dewhisna/LCDInterface_FFCP/README.md

# LCDInterface_FFCP

This repository contains custom LCD/SDCard/Keypad Interface board designs for the FlashForge Creator Pro printer (primarily the 2016 model FFCP).
