dewhisna/LCDInterface_FFCP/LCDInterface_FFCP-V1/LCDInterface_FFCP.xls

Quantity | References | Source | Order Part | Value | Description | Notes
9 | C1,C2,C3,C5,C6,C7,C9,C10,C11 | DigiKey | 478-3618-1-ND | 0.1uF | 0.10µF ±10% 50V Ceramic Capacitor X8R 1206
2 | C4,C8 | DigiKey | 493-9444-1-ND | 47uF 10V | UUA1A470MCL1GS: 47uF 10V SMD 6.3mmX5.8mm, 105C, cap
2 | D1,D3 | DigiKey | 160-1404-1-ND | LTST-C150KGKT | Lite-On LTST-C150KGKT Green LED, 1206 SMT | Optional
1 | D2 | DigiKey | 160-1404-1-ND | LTST-C150KRKT | Lite-On LTST-C150KRKT Red LED, 1206 SMT | Optional
1 | J1 | Amazon | B00PZNZNCM or B00E1L9YD8 | #19608 | 4UCon #19608 SDCard Socket
1 | P1 | DigiKey | S9181-ND | SBH11-PBPC-D13-RA-BK | Sullins 26-pin Male Right-Angle through-hole 0.100" dual row header
1 | P2 | DigiKey | SAM1011-16-ND | BCS-116-L-S-TE | 16-pin Female straight through-hole 0.100" single row header
1 | P3 | DigiKey | SAM1011-12-ND | BCS-112-L-S-TE | 12-pin Female straight through-hole 0.100" single row header
1 | R3 | DigiKey | 311-22.0FRCT-ND | 22 Ohm | 22 Ohm ±1% 0.25W, 1/4W Chip Resistor 1206 Moisture Resistant Thick Film
1 | R6 | DigiKey | 311-220FRCT-ND | 220 Ohm | 220 Ohm ±1% 0.25W, 1/4W Chip Resistor 1206 Moisture Resistant Thick Film
1 | R19 | DigiKey | 311-330FRCT-ND | 330 Ohm | 330 Ohm ±1% 0.25W, 1/4W Chip Resistor 1206 Moisture Resistant Thick Film | Only Populate if installing D3
2 | R5,R7 | DigiKey | 311-560FRCT-ND | 560 Ohm | 560 Ohm ±1% 0.25W, 1/4W Chip Resistor 1206 Moisture Resistant Thick Film | Only Populate if installing corresponding D1 and/or D2
5 | R14,R15,R16,R17,R18 | DigiKey | 311-1.00KFRCT-ND | 1K Ohm | 1K Ohm ±1% 0.25W, 1/4W Chip Resistor 1206 Moisture Resistant Thick Film
1 | R8 | DigiKey | 311-2.20KFRCT-ND | 2.2K Ohm | 2.2K Ohm ±1% 0.25W, 1/4W Chip Resistor 1206 Moisture Resistant Thick Film | Only Populate if not installing RV1
8 | R1,R2,R4,R9,R10,R11,R12,R13 | DigiKey | 311-10.0KFRCT-ND | 10K Ohm | 10K Ohm ±1% 0.25W, 1/4W Chip Resistor 1206 Moisture Resistant Thick Film | Only Populate R4 if not installing RV1
1 | RV1 | DigiKey | TC33X-103ECT-ND | 10K Ohm Trimmer | 10k Ohm 0.1W, 1/10W J Lead SMT Trimmer Potentiometer Cermet 1 Turn Top Adj. | Only Populate if not installing R4 and R8
3 | TV1,TV2,TV3 | DigiKey | 497-3711-1-ND | ESDA6V1U1RL | TVS Diode Array, 8-SOIC
4 | U1,U2,U3,U4 | DigiKey | 568-5461-1-ND | 74LVC1T45GW,125 | Voltage Level Translator Bidirectional 1 Circuit 1 Channel 420Mbps 6-TSSOP
1 | U5 | DigiKey | 568-2257-1-ND | HEF4094BT,653 | 8-stage shift-register, 16-SOIC
1 | U6 | DigiKey | LM1117MP-3.3/NOPBCT-ND | LM1117MP-3.3 | Linear Voltage Regulator IC Positive Fixed 1 Output 3.3V 800mA SOT-223
2 | N/A | DigiKey | 240-2103-ND | Ferrite Core | Clip-Together Ferrite Core 250 Ohm @ 100MHz
