dewhisna/LCDInterface_FFCP/LCDInterface_FFCP-V1/LCDInterface_FFCP.pdf

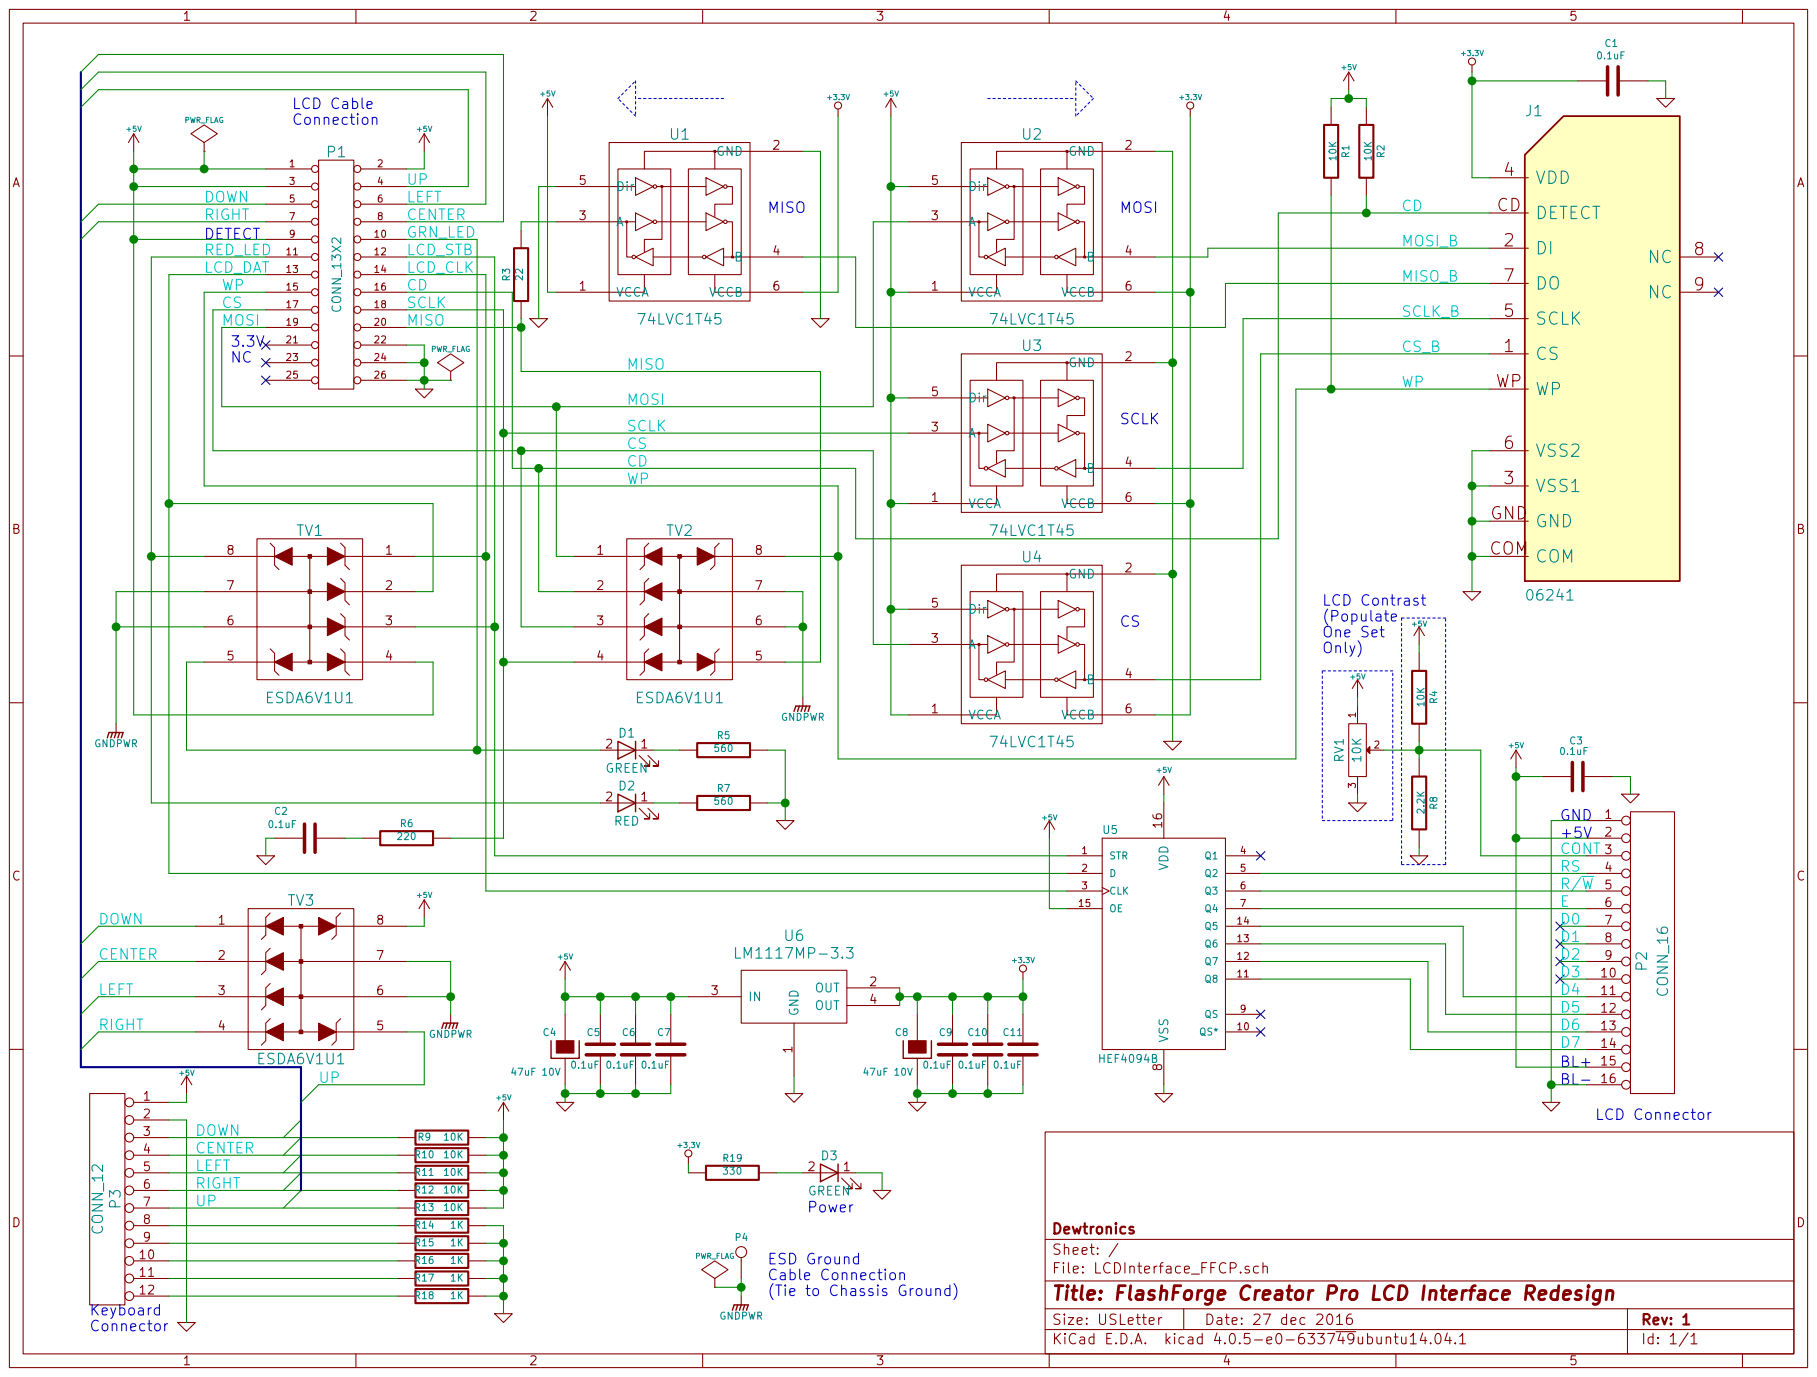
[picture p1: page 1]

DOWN 5 | | 6
RIGHT | | 7 | | 8
DETECT | | 9 | | 10

11 | | 12 | LCD_STB

LCD_DAT | 13 | | 14 | LCD_CLK

15 | | 16
17 | | SCLK 18

MOSI | | | 20

VCCB | 4 Dir 5 6 U3

SCLK
CS
CD

8 QS 9 QS* 10 Q8 11 Q7 12 Q6 13 Q5 14 OE 15 VDD 16 U5 HEF4094B

R/W 5
E 6

File: LCDInterface_FFCP.sch Sheet: / Dewtronics

Cable Connection
(Tie to Chassis Ground)

Id: 1/1 Title: FlashForge Creator Pro LCD Interface Redesign
