dewhisna/LCDInterface_FFCP/LCDInterface_FFCP-V1/LCDInterface_FFCP.kicad_pcb

## KiCad design LCDInterface_FFCP-V1/LCDInterface_FFCP.kicad_pcb (2019-07-04)

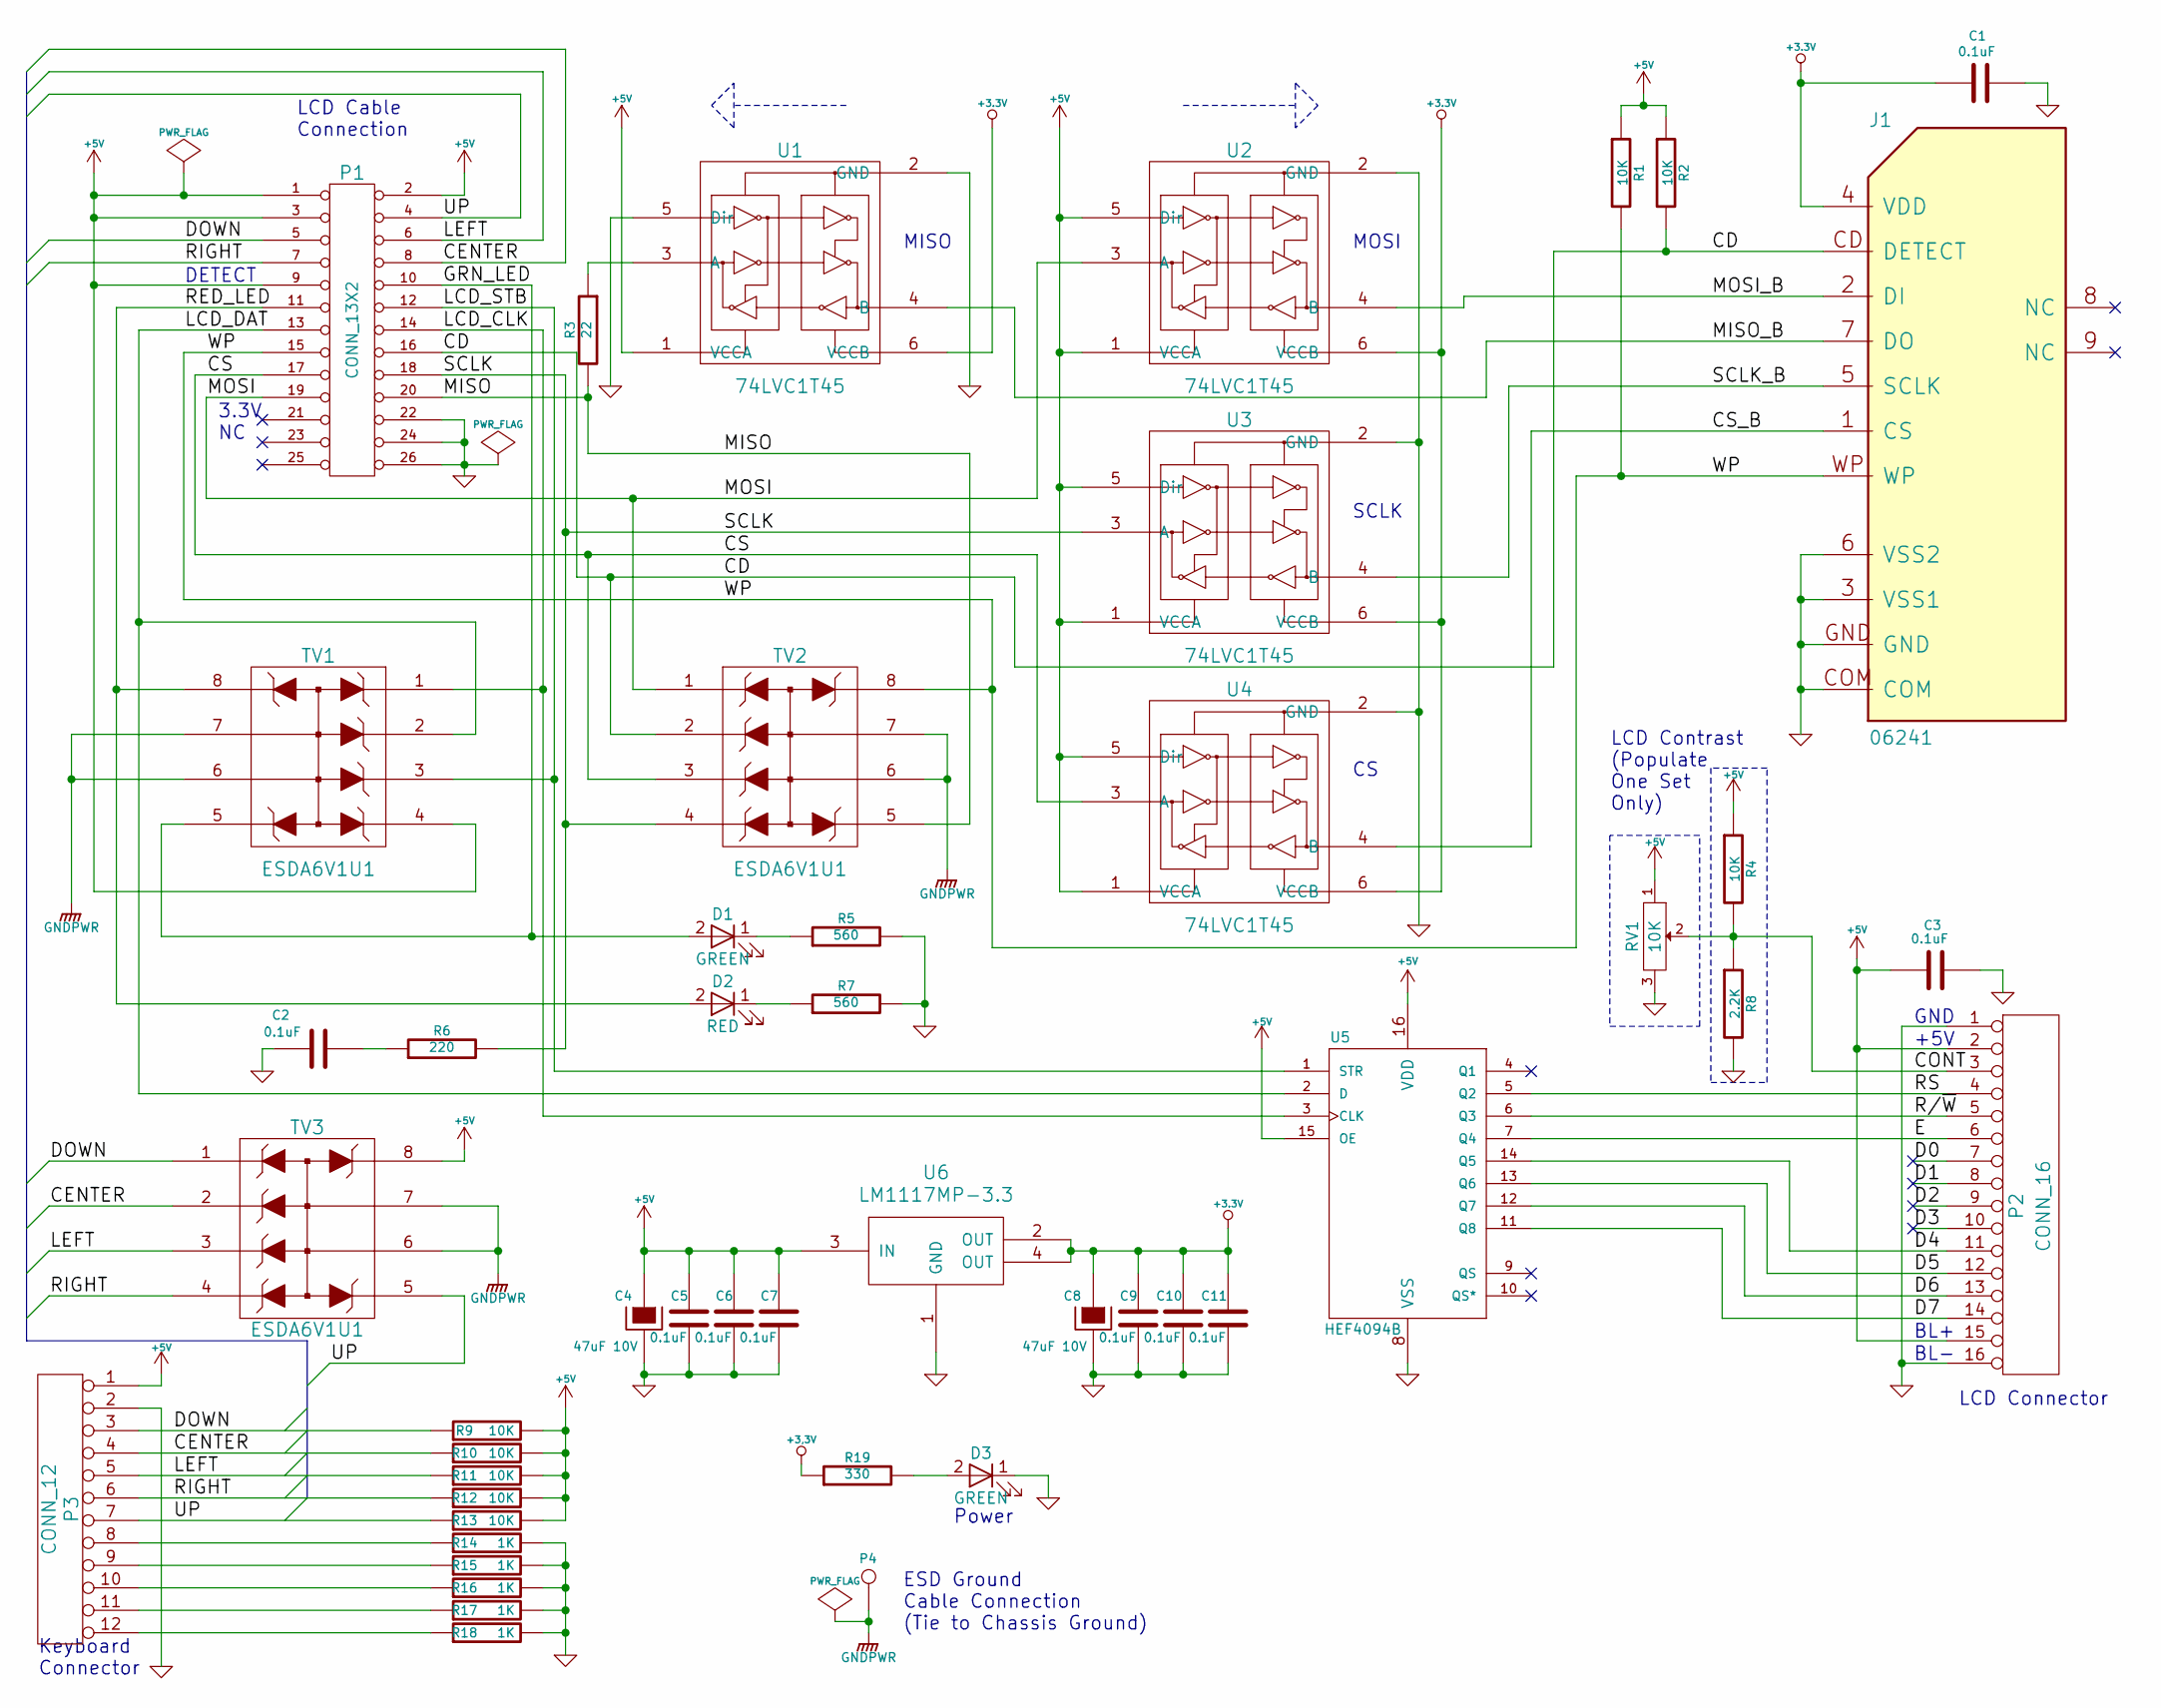
[picture p2: schematic LCDInterface_FFCP.sch, FlashForge Creator Pro LCD Interface Redesign]

Parts:
C1, C2, C3, C5, C6, C7, C9, C10, C11: 0.1uF; C_1206_HandSoldering
C4, C8: 47uF 10V; c_elec_6.3x5.8
D1, D3: GREEN; LED_1206
D2: RED; LED_1206
J1: 06241; SDCARD-SOCKET
P1: CONN_13X2; PAK100_2500-5-26
P2: CONN_16; con-molex-70543-16
P3: CONN_12; con-molex-70543-12
P4: CONN_1; 1pin
R1, R2, R4, R9, R10, R11, R12, R13: 10K; R_1206_HandSoldering
R3: 22; R_1206_HandSoldering
R5, R7: 560; R_1206_HandSoldering
R6: 220; R_1206_HandSoldering
R8: 2.2K; R_1206_HandSoldering
R14, R15, R16, R17, R18: 1K; R_1206_HandSoldering
R19: 330; R_1206_HandSoldering
RV1: 10K; Potentiometer_Trimmer-EVM3E
TV1, TV2, TV3: ESDA6V1U1; 74xx-us-SO08
U1, U2, U3, U4: 74LVC1T45; SC-70-6_Handsoldering
U5: HEF4094B; 74xx-us-SO16
U6: LM1117MP-3.3; SOT-223

Connections:
+5V: C3.1, C4.1, C5.1, C6.1, C7.1, P1.1, P1.2, P1.3, P1.9, P2.2, P2.15, P3.1, R1.1, R2.1, R4.1, R9.2, R10.2, R11.2, R12.2, R13.2, RV1.1, TV1.4 (I/O_4), TV3.8 (I/O_6), U1.1 (VCCA), U2.1 (VCCA), U2.5 (Dir), U3.1 (VCCA), U3.5 (Dir), U4.1 (VCCA), U4.5 (Dir), U5.15 (OE), U5.16 (VDD), U6.3 (IN)
/CD: J1.CD (DETECT), P1.16, R2.2, TV2.2 (I/O_2)
/CENTER: P1.8, P3.4, R10.1, TV3.2 (I/O_2)
/CONT: P2.3, R4.2, R8.1, RV1.2
/CS: P1.17, TV2.3 (I/O_3), U4.3 (A)
/CS_B: J1.1 (CS), U4.4 (B)
/D0: P2.7
/D1: P2.8
/D2: P2.9
/D3: P2.10
/D4: P2.11, U5.14 (Q5)
/D5: P2.12, U5.13 (Q6)
/D6: P2.13, U5.12 (Q7)
/D7: P2.14, U5.11 (Q8)
/DOWN: P1.5, P3.3, R9.1, TV3.1 (I/O_1)
/E: P2.6, U5.7 (Q4)
/GRN_LED: D1.2 (A), P1.10, TV1.5 (I/O_5)
/LCD_CLK: P1.14, TV1.1 (I/O_1), U5.3 (CLK)
/LCD_DAT: P1.13, TV1.2 (I/O_2), U5.2 (D)
/LCD_STB: P1.12, TV1.3 (I/O_3), U5.1 (STR)
/LEFT: P1.6, P3.5, R11.1, TV3.3 (I/O_3)
/MISO: P1.20, R3.2, TV2.5 (I/O_5)
/MISO_B: J1.7 (DO), U1.4 (B)
/MOSI: P1.19, TV2.1 (I/O_1), U2.3 (A)
/MOSI_B: J1.2 (DI), U2.4 (B)
/R/~W: P2.5, U5.6 (Q3)
/RED_LED: D2.2 (A), P1.11, TV1.8 (I/O_6)
/RIGHT: P1.7, P3.6, R12.1, TV3.4 (I/O_4)
/RS: P2.4, U5.5 (Q2)
/SCLK: P1.18, R6.2, TV2.4 (I/O_4), U3.3 (A)
/SCLK_B: J1.5 (SCLK), U3.4 (B)
/UP: P1.4, P3.7, R13.1, TV3.5 (I/O_5)
/WP: J1.WP, P1.15, R1.2, TV2.8 (I/O_6)
GNDPWR: P4.1, TV1.6 (GND), TV1.7 (GND), TV2.6 (GND), TV2.7 (GND), TV3.6 (GND), TV3.7 (GND)
unnamed: C2.2, R6.1
unnamed: D1.1 (K), R5.1
unnamed: D2.1 (K), R7.1
unnamed: D3.2 (A), R19.2
unnamed: P3.8, R14.1
unnamed: P3.9, R15.1
unnamed: P3.10, R16.1
unnamed: P3.11, R17.1
unnamed: P3.12, R18.1
unnamed: R3.1, U1.3 (A)

Notes on the sheet:
GND
+5V
LCD Contrast (Populate One Set Only)
BL+
BL-
LCD Cable Connection
LCD Connector
Keyboard Connector
3.3V NC
MOSI
SCLK
MISO
DETECT
Power
ESD Ground Cable Connection (Tie to Chassis Ground)

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
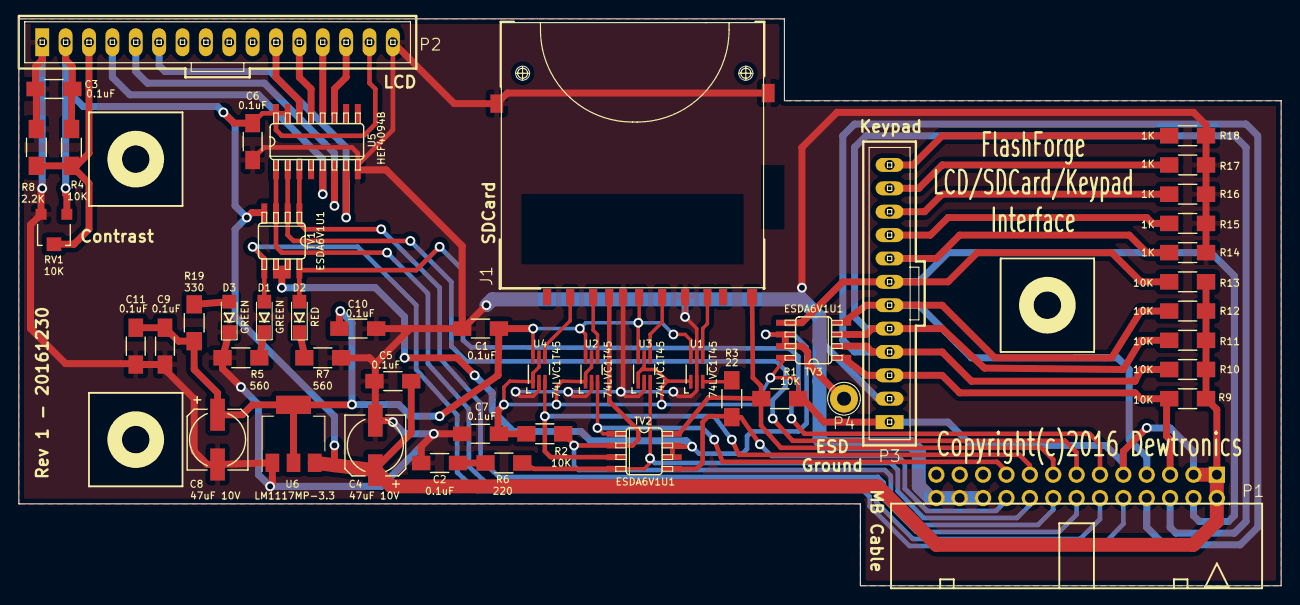
[picture p3: board LCDInterface_FFCP.kicad_pcb from above]

Board: 2 copper layers, 137.2 x 61.6 mm, 51 parts (0 on the bottom side), 42 nets.

Other parts of the board:
1PIN, 1PIN#2, 1PIN#3: P***; 1pin
