dewhisna/LCDInterface_FFCP/(notices)

Notices in the files:
LCDInterface_FFCP-V1/LCDInterface_FFCP.kicad_pcb:
Copyright(c)2016 Dewtronics
